HexabitzPlatform/H1AR0x/README.md

# H1AR0x-Hardware
Hexabitz USB-C-to-UART Converter Module Hardware Design
