HexabitzPlatform/H1AR0x/Documentation/H1AR0 Schematics.pdf

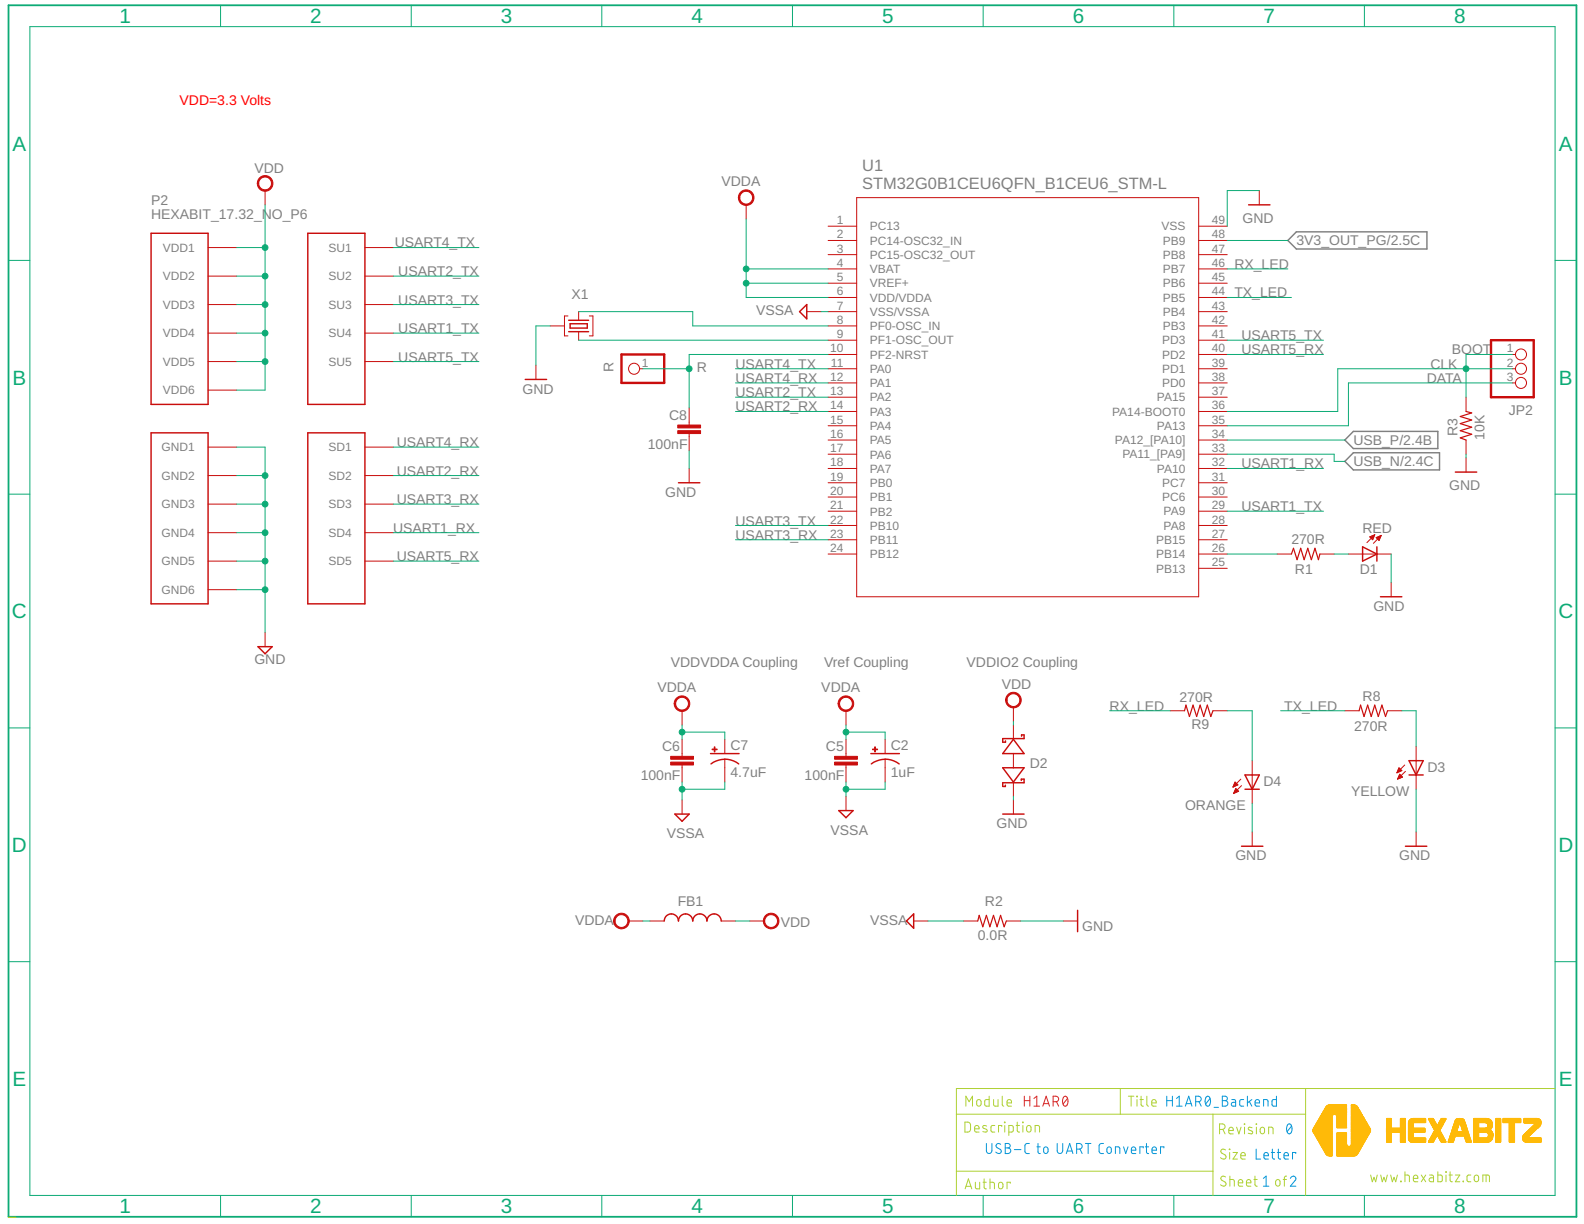
[picture p1: page 1]

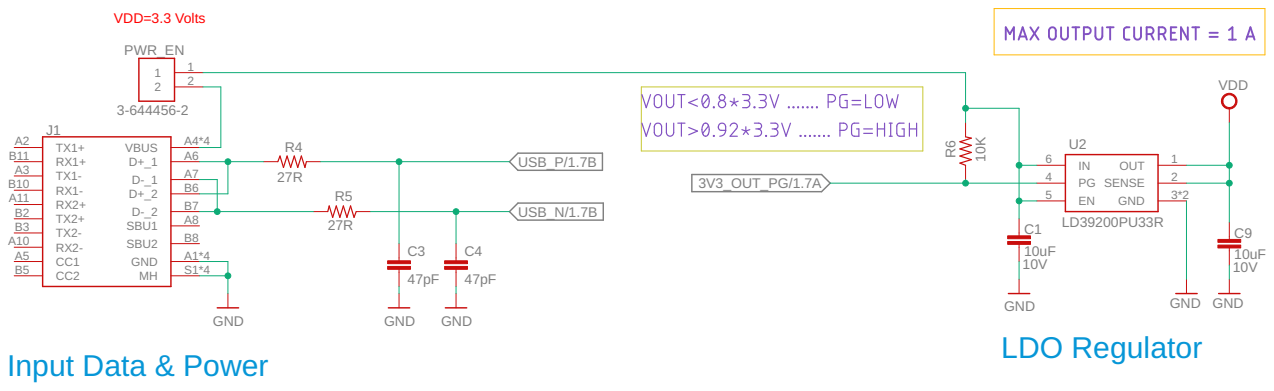
[picture p2: page 2]
