HexabitzPlatform/H1AR0x/(commit log)

2024-12-14 All Finish, Reviewed Version
    [H1AR0.brd, H1AR0.sch, H1AR0.xlsx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]
2025-01-15 Fix BOM
    [H1AR0.xlsx]
