HexabitzPlatform/H1AR0x/(notices)

Notices in the files:
parts and their libraries:
HEXABITZ_ICs: COPYRIGHT: Copyright (C) 2021 Ultra Librarian. All rights reserved.
